yone-haru/coin-sorting-bank/hardware/sorter/sim/frame1.png

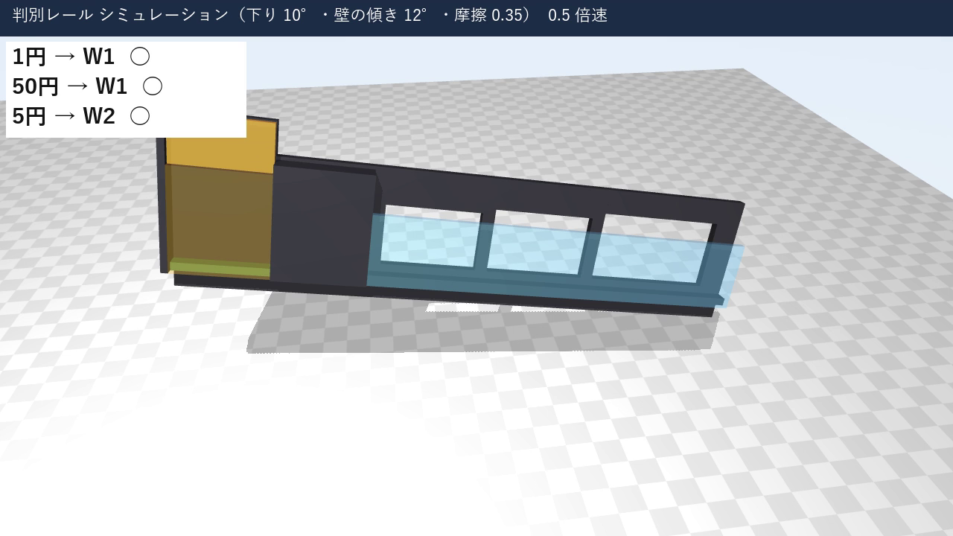
hardware/sorter/sim/frame1.png
