yone-haru/coin-sorting-bank/hardware/sorter/sim/test_frame.png

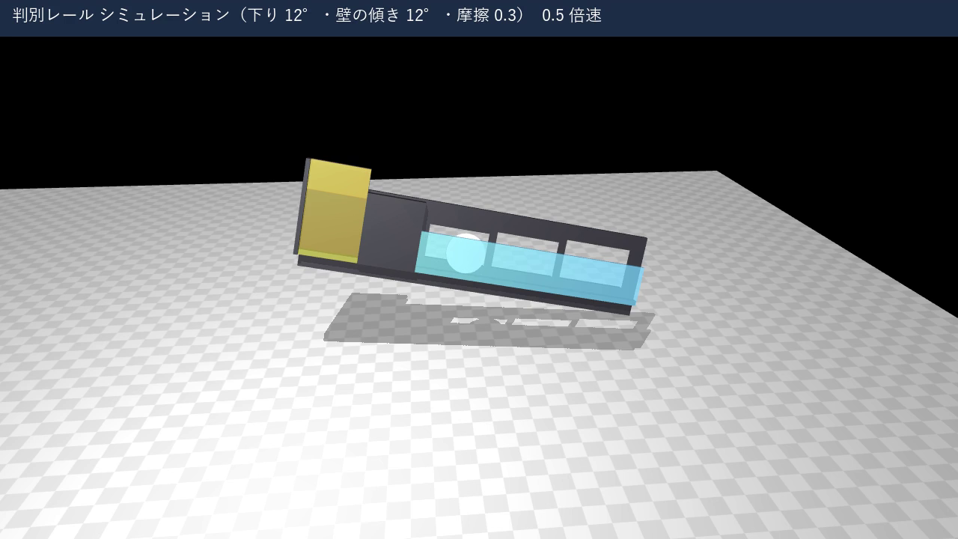
hardware/sorter/sim/test_frame.png
