yone-haru/coin-sorting-bank/hardware/sorter/ICB-86_実装手順.md

# ICB-86 無切断の中継基板実装

現物の ICB-86 を切らずに使う。穴の位置は **[ICB-86_配線図.html](ICB-86_配線図.html)** を参照（`python gen_ICB86配線html.py` で生成）。`基板設計/錫線だけ_配線図.html` と同じ形で、上が部品面から透かして見た図、下が裏返したはんだ面の図（左右反転）。橙色の線がつなぐ線で、図の端の文字がその線の元（センサーのどの足か・CN1 の何番か）。下の 2 つの表（先に付ける抵抗 5 本・これから付ける線 27 本。from・to・道・はんだの注意）にチェックを付けながら進める（チェックはブラウザに保存。付けた線は図でも灰色になる）。写真と同じく、銅箔面を見て「ICB-86」の文字を上にした向きで段数を数える。

**センサー本体は判別レールの指定穴に取り付ける。ICB-86にはセンサー本体を付けない。**レールから引いた線をICB-86へつなぐ。ICB-86に載せる部品は220Ω抵抗5本で、抵抗は銅箔面の反対側に置く。

| センサー | 赤外LED本体の位置 | 受光素子本体の位置 |
|---|---|---|
| P1・P2・P3 | 判別レールの床の下 | 硬貨の上側 |
| 穴A・穴B | 橋の塔 | レール裏の受光ホルダー |

## 銅箔の使い方

- 中央左の縦1列を **+5V**、中央右の縦1列を **GND** とする。2列は別の銅箔。
- 左の横3穴は各段で独立している。上から5～9段を、5個の **LED＋** に割り当てる。
- 右の横3穴も各段で独立している。上から12～16段を、5個の **受光C信号** に割り当てる。
- 抵抗は5本とも **220Ω**。各抵抗の片足を中央左+5V列、もう片足を同じ段の左3穴帯の左端へ挿す。左3穴帯の残る穴に、その段のLED＋線をつなぐ。5本を共用の抵抗1本にまとめない。

| 上からの段 | 左3穴帯：抵抗の先につなぐもの | 右3穴帯：2本を同じ段につなぐもの |
|---:|---|---|
| 5 | P3 LED＋ | — |
| 6 | P2 LED＋ | — |
| 7 | P1 LED＋ | — |
| 8 | 穴A LED＋ | — |
| 9 | 穴B LED＋ | — |
| 12 | — | P3 受光C、CN1-1 青 |
| 13 | — | P2 受光C、CN1-2 緑 |
| 14 | — | P1 受光C、CN1-3 黄 |
| 15 | — | 穴A 受光C、CN1-5 白 |
| 16 | — | 穴B 受光C、CN1-6 残りの1色 |

CN1-7の赤線は+5V縦列の1段へ。CN1-8の黒線はGND縦列の11段へ。各LEDの－はGND縦列の1～5段へ1本ずつ、各受光のEは同じGND縦列の6～10段へ1本ずつつなぐ。CN1-4は中継基板へ引かず、制御基板側でCN1-8へ接続済み。

**素子の足：**赤外LED `OSI5LA5113A` は長い足が＋（アノード）、短い足が－（カソード）。受光素子 `L-51ROPT1D1` は**短い足がC（コレクタ）、長い足がE（エミッタ）**。足を切る前に＋/－・C/Eを印しておく。根拠：[赤外LEDのデータシート](https://akizukidenshi.com/goodsaffix/OSI5LA5113A.pdf)、[受光素子の商品説明](https://akizukidenshi.com/catalog/g/g104211/)。

## 作業と確認

1. 12V電源とUSBを外す。220Ω抵抗5本を5～9段へ取り付ける。
2. CN1からの7本とセンサー5組の線を上の表どおりにつなぐ。継ぎ目は熱収縮チューブで絶縁し、線はレールの溝と吊り板のクリップに収める。
3. 電源を入れる前に、+5V縦列とGND縦列の短絡がないこと、左のLED＋5段相互および右の信号5段相互が短絡していないことを確認する。各抵抗の+5V列からLED＋穴まで約220Ωを確認する。
4. 制御基板につなぎ、各センサーを1組ずつ遮光・通光させて `sensortest` の変化を確かめる。

2026-10-06 に **ICB-86を切らずに使う案に決定**した（ユーザー指示）。`配線と固定.md`・`配線図_中継基板.png`・`基板設計/製作手順_制御基板.html` の「32×28mmに切ってレールの台に留める」記述はこの案に書き換えた。① 判別レールの中継基板の台とねじ2本は使わない（台は印刷済みのまま）。`組立図_本番/06_配線.png` とCADは中継基板を旧い台の位置で描いているので、線の長さは現物のICB-86に当てて決める。穴の割り当ては現物ではまだ確かめていない（上の「作業と確認」3で測る）。
