yone-haru/coin-sorting-bank/hardware/sorter/設計メモ.md

# 自作判別部 設計メモ（2026-09-26 着手）

> **2026-09-27：物理シミュレーションで寸法を決め直し、本番の形まで設計した（第 6・7 章）。**
> 本番の CAD は `判別ユニット_本番.scad`（STL は `本番STL/`、組立図は `組立図_本番/`）。
> 第 2〜4 章と `判別レール.scad`・`判別レール_試験一式.stl`・`組立図_自作.scad` は **9/26〜27 朝の旧案**（勾配 6°・傾き 20°・縁石なし）。
> 旧案のまま印刷すると、シミュレーションでは硬貨が途中で止まる。**印刷しないこと。**

とりだし君をやめ、判別部を含む制御ユニットの中身をすべて自前で設計する（ユーザー指示 9/26）。
オープンソースは仕組みの参考だけにして、形はすべてここで作る。**とりだし君案は自作版が各金種 50 枚の試験に合格するまで予備として残す。**

## 1. 判別方式の選定（調査の要約）

| 方式 | 5円/100円（0.6mm 差）の扱い | 判断 |
|---|---|---|
| 平置きで滑らせて穴に落とす（Improved Auto Coin Sorter など） | 穴の縁で 0.6mm を切る。勢いで飛び越える報告あり | × |
| 立てて転がし壁の窓から倒す（とりだし君と同じ原理） | 窓の高さで切る。射出成形なら ±0.3 で可、FDM では厳しい | ○（大まかに分ける用） |
| 高さの違う複数ビーム・2 ビームの時間差 | 光の境目がぼける・速度がばらつく | × |
| **穴センサー**（5円・50円の中心の穴を光が一瞬通る） | 穴 φ4〜5 に対しビーム φ1.5。余裕が桁違いに大きい | ◎（補助として） |
| 電子セレクタ・コイル・重さ・色 | 部品の追加や校正が要る | × |

**採用：「窓で 4 つに大まかに分ける ＋ 穴センサー 2 本」**

| レーン | 窓の高さ | 落ちる硬貨 | 同じレーンの 2 枚を分ける |
|---|---|---|---|
| W1 | 21.5 | 1円 20.0・50円 21.0 | 穴あり→50円 / なし→1円 |
| W2 | 23.05 | 5円 22.0・100円 22.6 | 穴あり→5円 / なし→100円 |
| W3 | 25.0 | 10円 23.5 | （穴なしを確認） |
| 終端 | — | 500円 26.5 | （穴なしを確認） |

- 0.6mm 差の 5円/100円 の境目を機械で切らない。機械のしきい値の余裕は最小 ±0.45mm（100円/10円）
- 穴センサーは 2 本（冗長）。1円/50円 と 5円/100円 のどちらも穴の有無だけで決まる
- 入力は 4 レーン＋穴 2 本＝**6 本。今の基板・配線・ピン（GPIO 4,5,3,10,20,21）をそのまま使える**

## 2. 形（判別レール）

- 壁の板（厚 3）に床リブ（幅 4）。硬貨は床の上に立ち、後ろへ 20° 傾いた壁にもたれて転がる（下り 6°）
- 窓は床の面から高さ H まで板を貫通。H より背の低い硬貨は支えを失い、壁の裏へ倒れて落ちる
- 窓の長さは「倒れ始め（硬貨の中心が上流の縁を越える）から抜けきるまで」の転がり量を見込んで 30 / 32 / 34mm（9/27 に着地場所 28mm を足すため 32/35/38 から詰めた）。
  下流側の縁は裏側へ 45° 面取りして、倒れかけた硬貨を裏へ導く
- 板を平置きで印刷（硬貨がもたれる面が上）。**窓の高さ＝しきい値が XY 方向になるので精度が出る**（補正 +0.1 は試験で合わせる）
- 穴センサーは上流の「橋」の下。LED は橋の塔に上から差し、受光素子は板の裏から。φ1.5 の絞り穴は同じ部品に開けるので位置が合う

## 3. 試験（`判別レール_試験一式.stl`）

一式：判別レール／受光素子ホルダー（裏に付ける）／試験台 2 個（上流・下流）。黒・壁 4 周・インフィル 30%・サポートなし。

1. 台 2 個の段に板の下端を載せ、裏を斜面にもたせる（勾配 6°・傾き 20°）
2. 上流端の床に硬貨を立て、壁にもたれさせて手を離す。各金種 10 回ずつ、どの窓で落ちるかを数える
   - 期待：1円・50円→W1、5円・100円→W2、10円→W3、500円→最後まで転がる
   - 見るところ：100円が W2 で落ちるか（余裕 0.45）、10円が W2 を越えるか（余裕 0.45）、硬貨が途中で止まらないか、窓を飛び越えないか
3. 穴センサー：橋の塔に LED、裏のホルダーに受光素子を差し、ブレッドボードの XIAO につなぐ（1 本で可）。
   `sensortest` で転がすと、穴あき硬貨（5円・50円）は **1 枚で HIGH が 2 回に割れる**。穴なしは 1 回
4. 結果で調整するもの：窓の高さの補正 `win_comp`、窓の長さ、勾配・傾き（台を作り直す）

## 4. 本番の構成（試験のあとで作る）

- 蓋の取付位置（投入スリット (175,56)・ボス）は変えない（クライアントの蓋は寸法図どおり）
- じょうご→関門 2.6mm→判別レールの上流端（着地場所 28mm）へ。**関門はスリットの左端の真下（X=155）**、
  レールは **右（+X）へ下り、硬貨の面は手前**、窓から倒れた硬貨は壁の奥側のシュートへ（2026-09-27 組立図で決定）。
  収まり：X 137〜329／Y 31〜82／蓋の裏から 163mm（箱の内側 X・Y 5〜345・内高 347）
- **注意：蓋の座標（X 右・Y 手前・Z 上）は鏡映し。**本物の形の STL を蓋の座標で置くときは Y で鏡映しにする（`組立図_自作.scad` の `pose()`）。
  本番のシュート・吊り具を蓋の座標で作ったら、印刷用 STL は `mirror([0,1,0])` して実物の向きに戻す
- 組立図：`python gen_組立図.py` → `組立図/01〜05_*.png`
- 窓の裏にシュート（硬貨を真下へ落とす溝）を付け、各シュートを横切るビームでレーンを検出（LED・受光素子の穴はシュートの部品に一体）
- 基板室は今の設計のまま流用

## 5. ファームウェアの変更（試験で穴の信号を確かめてから）

- ピンの意味だけ変える：GPIO4=500円（終端）／GPIO5=W2（5円・100円）／GPIO3=W1（1円・50円）／GPIO10=W3（10円）／GPIO20=穴 A／GPIO21=穴 B
- 穴ビームの 1 回の通過で「HIGH が 2 回に割れ、間の LOW が短い（全体の 1〜4 割）」→ 穴あり。
  硬貨 2 枚が接して通ると割れ目がほぼ 0 になるので、割れ目の比率で見分ける
- 穴の判定を FIFO に積み、レーンの検出が来たら古い順に取り出して金種を決める（硬貨はレール上で追い越さない）
- `CLAUDE.md` の「パルスを数える処理を書かない」「レーン＝金種」と食い違うので、採用が決まったら仕様を書き換える
- **9/27 変更：レーンのセンサーは「窓の裏」ではなく「溝を縦に貫く通過センサー P1〜P3」になった（第 7 章）。ピンの意味は第 7 章の表が正**

## 6. 物理シミュレーション（2026-09-27）

`sim/coin_sim.py`（MuJoCo 3.14）。寸法は `selfsort_params.scad` をそのまま読むので、CAD とずれない。

| コマンド | 内容 |
|---|---|
| `python coin_sim.py check` | 今の寸法で 6 金種を 1 回ずつ |
| `python coin_sim.py sweep '{"alpha":[8,10],...}'` | 形の組み合わせを総当たり → `analyze.py` で「ばらつきの中で一番悪い判別率」順に並べる |
| `python focus.py '{}' --seeds 16` | 1 つの形を、摩擦 0.2〜0.5・跳ね・窓の高さの印刷誤差 ±0.15 で何百回も |
| `python sensor_eval.py '{}'` | センサーの光を毎ステップ当てて、遮る・遮らないを確かめる |
| `python coin_sim.py video out.mp4` | 動画（`判別シミュレーション.mp4`） |

**分かったこと（旧案の欠陥）**

1. **勾配 6°・傾き 20° では硬貨が止まる。**壁との摩擦（μ × sin 傾き）が下りの力（sin 勾配）とほぼ同じ。→ 勾配 10°・傾き 12°
2. **窓が床の面から開いていると、大きい硬貨も落ちる。**窓の中では硬貨の下の縁を止めるものが無く、下の縁が窓へ滑り込む → 窓の下に**縁石 2.5mm**
3. **着地で跳ねた硬貨が W1 まで跳ね続け、窓から入り込む。**→ 着地場所の床に**フェルト 2mm**（無いと厳しい条件で 83%、あると 96〜99%）
4. **手前へ倒れて外へ出る。**→ 溝の手前に**前板**（すき間 4.5・床から 20mm）。すき間は「硬貨の厚み＋縁石＋余裕」必要（2.6 だと小さい硬貨が縁石を越えられず挟まる）
5. 10 円が W3 を飛び越える（終端で一番速い）→ W3 を 34→38
6. 窓の下流の縁は**角のまま**。表側を面取りすると落ちるべき硬貨まで壁へ押し戻される（27〜41% に悪化）。裏側の面取りは効果なし
7. 傾きは **12° が最良**（10° で 93%、14° で 98%）。組立の誤差は ±1° 以内に。勾配は 9〜11° でほぼ同じ

**最終の判別率**（計算が破綻した回＝物理的にあり得ない速さの回は除く）

| 条件 | 判別率 |
|---|---|
| 普通（摩擦 0.3〜0.4・跳ね普通・窓の高さ ±0.1） | **98.9%**（750/758） |
| 厳しい（摩擦 0.2 / 0.5・よく跳ねる・±0.15） | **98.6%**（343/348） |

残りの失敗は「途中で止まる」がほとんど。シミュレーションの摩擦は実物より「張り付き」やすい癖があり、実物では減る見込み（実機で確認）。
**シミュレーションは実物の代わりではない。**摩擦・跳ねを幅で振って「どの条件でも通る形」を選んだもの。最後は印刷して各金種 50 枚で確かめる。

## 7. 本番の構成（`判別ユニット_本番.scad`）

| 部品 | 大きさ | 印刷 |
|---|---|---|
| ① 判別レール | 179 × 105 × 20 | 硬貨がもたれる面を上。**PETG**（黒がよい）・壁 4・インフィル 30%・サポートなし。横向きの φ1.0 の絞り穴は印刷で埋まったら 1mm ドリルで通す。配線の溝（上下）と中継基板の台つき |
| ② 前板 | 121 × 25 × 2.5 | 内面を下 |
| ③ 受光ホルダー | 28 × 40 × 12 | そのまま |
| ④ 吊り板＋じょうご | 142 × 81 × 46 | 蓋に当たる面を下（腕とじょうごが上に立つ） |

- 取付：④ を蓋のボス 4 本に M4。① のマスト 2 本を ④ の腕に M3×8 タッピング 4 本（硬貨側から。9/27 に ×10 から直した：ねじは全部 ×8 にそろえる・×8 でも 5mm 以上かかる）。② は M3 3 本、③ は裏から M3 2 本
- **配線と固定：`配線と固定.md`**（センサーの線は上下の配線の溝へ、中継基板で手持ちの耐熱ワイヤー 7 本の束にまとめ、吊り板の下の印刷クリップで留めて基板室の CN1 へ。材料は PETG。買い足す物は無し）
- フェルト：**使わない**（2026-09-27 決定。床は平ら）。よく跳ねる条件でだけ効く（あり 98.6%・なし 87.8%）ので、試験で跳ねが目立てば予備の `①判別レール_フェルトあり（予備）.stl` とフェルト 2mm に切り替える
- ねじ：M3×8 タッピング 25 本・M4×10 タッピング 8 本＋M4 ワッシャー 8 枚（貯金箱全体。内訳は `配線と固定.md` 第 5 章）
- 色：灰色の PETG。センサーのブロックは壁を厚くし、印刷後に外側を黒の油性ペンで塗る
- 置き場所：関門の口を (X 165, 奥から 56, 蓋の裏から 35)。レールは X 142〜319。④ は蓋のリブの無い範囲（X 132〜274・奥から 16〜96）に収まる
- **座標は右手系（Y＝奥向き）で作った。**蓋の図面の座標（Y＝手前向き）を 3D にそのまま使うと鏡像になるため（基板室の件と同じ）

**センサー（6 本・GPIO は今のまま）**

| GPIO | センサー | 位置 | 意味 |
|---|---|---|---|
| 20 | 穴 A | x 35（橋） | 硬貨が入った合図・穴の有無 |
| 21 | 穴 B | x 49（橋） | 同上（冗長） |
| 3 | 通過 P1 | x 98（W1 の後） | ここを通った＝1円/50円ではない |
| 5 | 通過 P2 | x 134（W2 の後） | ここを通った＝5円/100円ではない |
| 4 | 通過 P3 | x 173.5（W3 の後） | ここを通った＝500円 |
| 10 | 予備 | — | （使わない） |

**判定のしかた（ファーム v3.0 で実装済み・9/27。`firmware/lib/CoinTracker` ＋ `firmware/src/main_selfsort.cpp`。詳しくは第 9 章と `CLAUDE.md` 第 3A 章）**：穴 A/B で「入った」と「穴の有無」→ 入口から P1 まで最大 0.6 秒、P2 まで 0.77、P3 まで 0.82（シミュレーションの最大値）。
期限までに P1 を通らなければ W1（穴あり→50円・なし→1円）、P1 を通って P2 を通らなければ W2（穴あり→5円・なし→100円）、P2 を通って P3 を通らなければ 10円、P3 を通れば 500円。
硬貨はレール上で追い越さないので FIFO で追う。~~CLAUDE.md の「レーン＝金種」「パルスを数えない」とは食い違う~~ → 9/27 に CLAUDE.md へ第 3A 章（自作版）を足し、第 2〜3 章はとりだし君版と明記した

## 8. 全体テスト（2026-09-27 深夜）

`sim/system_test.py single|burst`。硬貨の物理 → センサー 5 本の信号 → 判定ロジック → 鳴る音 を通しで確かめる。
判定ロジックは同ファイルの `decide()`（v2）が**ファームに移す仕様の下書き**。結果と工程の抜けは `../../全体テストと工程チェック_2026-09-27.md`。

## 9. ファームウェア v3.0（2026-09-27）

`decide()`（第 8 章）を C++ に移した。**`firmware/lib/CoinTracker`**（判定・Arduino なし・PC で単体テスト）＋ **`firmware/src/main_selfsort.cpp`**（ISR・DFPlayer・ログ・コマンド）。
既定のビルドは `pio run -e esp32c3`（自作版）。とりだし君版 v2.1 は `pio run -e esp32c3_lane` で今でも作れる。仕様・定数・ログの形は `CLAUDE.md` 第 3A 章。

### 9.1 `decide()` との突き合わせ（シミュレーション 472 件＝1 枚ずつ 426・連続 46・硬貨 978 枚）

全体テストの 472 件のセンサー信号を `CoinTracker` に 1ms 刻みで流し、`decide()` の結果と比べた。

| 設定 | `decide()` と同じ結果 | 全部正しいケース | 正しい硬貨 ※ |
|---|---|---|---|
| 拾う機能なし（`SS_ADOPT_ORPHAN=false`） | **472/472**（決まる時刻の差も 0） | 451 | 817/978 |
| 拾う機能あり＋ **40ms の条件**（本番の設定） | 468/472 | **453** | **852/978** |

※ 枚数が合ったケースだけ入れた順に比べる（1 枚でも取りこぼしたケースは 0 と数える）ので、連続投入のケースで低く出る。

- 違った 4 件（462・463・467・471。どれも連続投入）は、**`decide()` が取りこぼした硬貨を拾って音を鳴らした**もの。
  うち 3 件は拾った金額も正しい。462 は枚数が合ったが、隣の 1 枚が 100円→5円 になった
- **40ms の条件（`SS_ADOPT_MIN_MS`）を入れた理由**：条件なしで拾うと、56・85・435 で**余計な音が 1 回ずつ**鳴った。
  P を通った硬貨が次の窓へ傾くとき、同じ P を 15〜31ms 遮り直すのが原因。本物の通過は 54ms 以上なので、40ms 以上の遮光だけを拾う。これで 3 件とも消えた

### 9.2 PC 上の結合テスト（`main_selfsort.cpp` をそのまま動かす）

Arduino・DFPlayer・WDT を PC 上の代わり（時計は 64bit の偽物）に置き換え、ISR からエッジを入れて音の番号とログを確かめた。**80/80 合格**（通常 66・起動時にビームが遮られている 8・DFPlayer なし 6）。

- 6 金種 × 速さ 5 通り（120/180/250/400/700 mm/s）で正しい音
- loop が 100ms 止まっても 6/6 正しい（ISR の時刻で判定しているため）／loop が 20ms ごとでも正しい
- `sim`（既定・120・900 mm/s・変な引数）、詰まり（`JAM?`・LED のゆっくり点滅）、`stats`/`reset`、`sensortest`（穴あき 50円で HA・HB が 2 回に割れる）
- DFPlayer が無いとき ERROR（LED 高速点滅・以後止まる）
- `micros()` の一周（約 71 分）をまたいでも正しい

### 9.3 分かった限界

- **2 枚の間隔**（250mm/s・HA に来る時刻の差。36 通りの組み合わせを 300→40ms で調べた）：
  多くの組み合わせは **170〜180ms** まで正しい。500円・10円・5円が前にいる組み合わせのいくつかは 90〜110ms まで大丈夫。
  **一番悪いのは 10円→50円・10円→1円 の 270ms**。これより詰まると 2 枚を 1 枚（穴あり）と数える。
  原因は `SS_GROUP_GAP_MS`（80ms）より短い光の戻りを同じ硬貨とみなすため（`decide()` も同じ）。ゲートで 1 枚ずつにするのが前提
- **長い遮光のあと**：HB が約 2.6 秒遮られてから光が戻ると、`NOTE noA longB` を出して 1 枚として音を鳴らした（金額は 1円・速さ不明）。
  詰まった硬貨が抜けたとき、手をかざしたときに起きる。無音よりよいと考えてそのままにしている（実機試験で困るなら見直す）

### 9.4 実機で確かめること

1. `sensortest` で 5 本のビームが硬貨で HIGH になるか（プルアップ 22kΩ で足りるか）。穴あき 50円・5円で HA・HB が 2 回に割れるか
2. 硬貨の実際の速さ（`COIN` 行の `v=`）→ 期限の係数 `SS_K_DEADLINE`・`SS_T_MARGIN_MS` を詰める（音が鳴るまでの時間を短くできる）
3. 各金種 50 枚で 98% 以上（判別率は `CSV` 行から集計）
