yone-haru/coin-sorting-bank/hardware/sorter/ICB-86_実装図.png

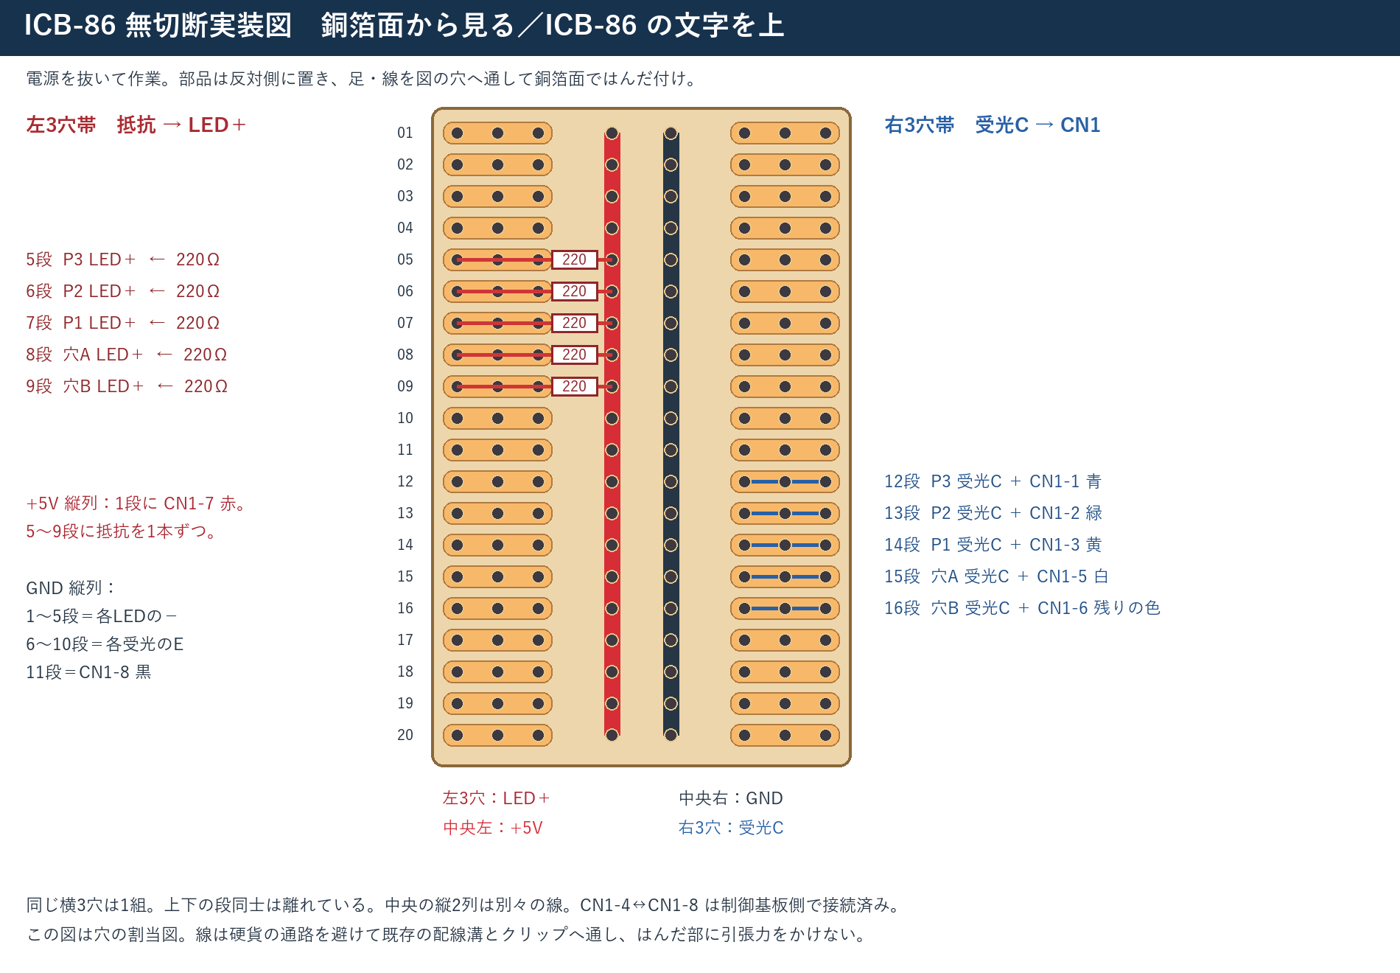
hardware/sorter/ICB-86_実装図.png
