yone-haru/coin-sorting-bank/hardware/sorter/sim/frame2.png

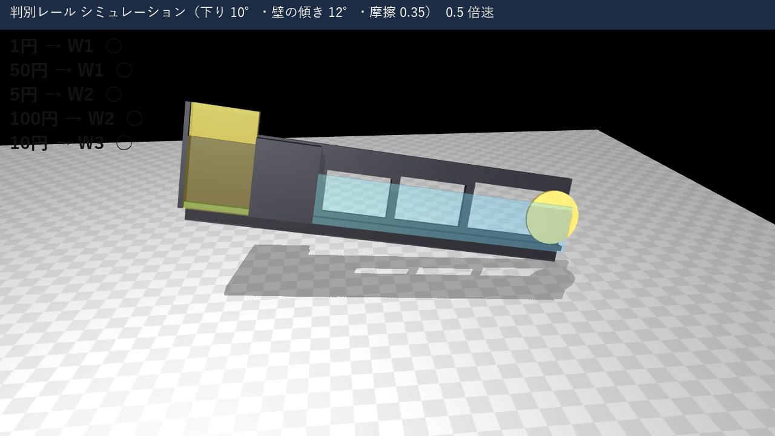
hardware/sorter/sim/frame2.png
