yone-haru/coin-sorting-bank/hardware/sorter/配線図_中継基板.png

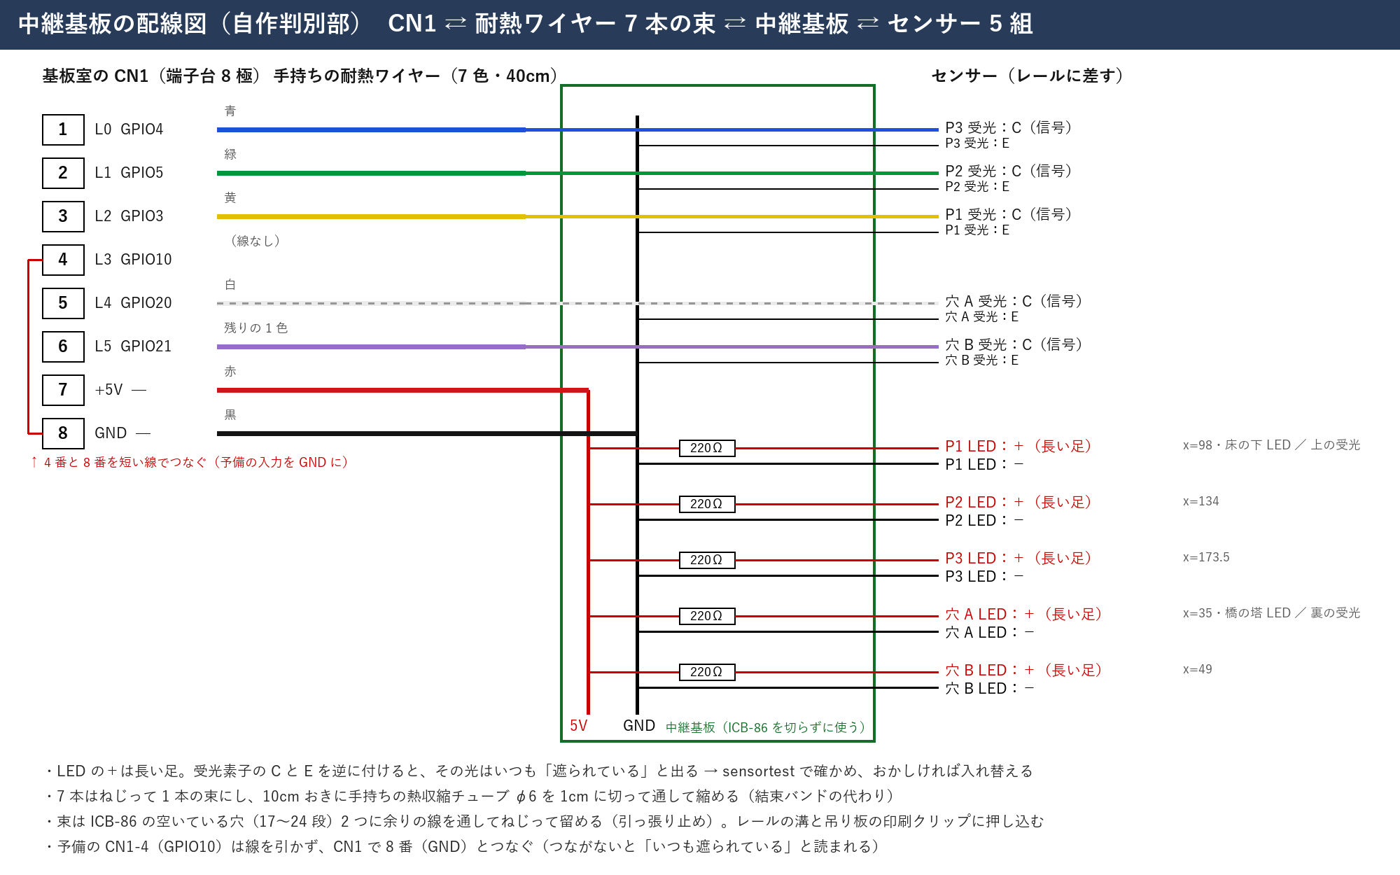
hardware/sorter/配線図_中継基板.png
