yone-haru/coin-sorting-bank/hardware/sorter/stl/⑤-1押さえ_通過LED×3.stl

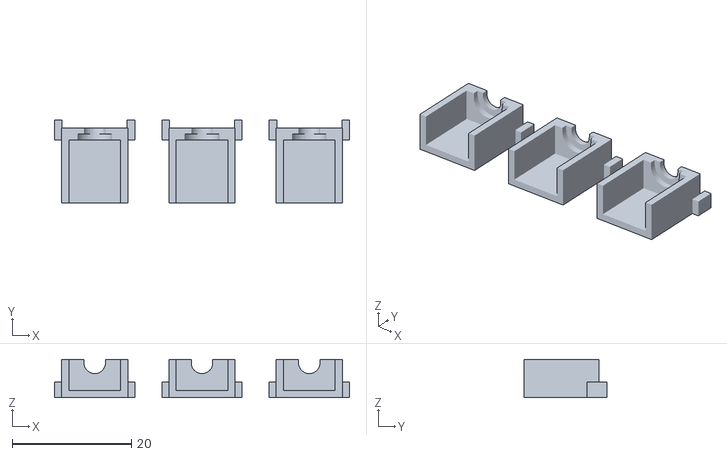
[picture p6: CAD file, 2026-10-10]
hardware/sorter/stl/⑤-1押さえ_通過LED×3.stl
49.5 x 13.9 x 6.45
