yone-haru/coin-sorting-bank/hardware/sorter/stl/⑤-2押さえ_通過受光×3.stl

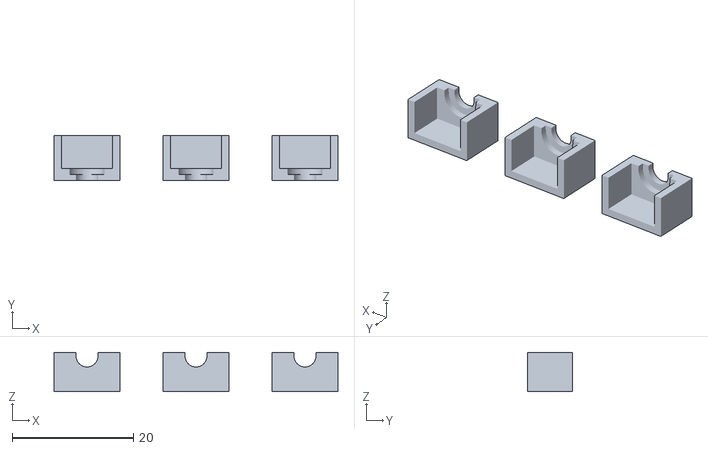
[picture p7: CAD file, 2026-10-10]
hardware/sorter/stl/⑤-2押さえ_通過受光×3.stl
46.9 x 7.40 x 6.45
