yone-haru/coin-sorting-bank/hardware/sorter/stl/⑧脚×4.stl

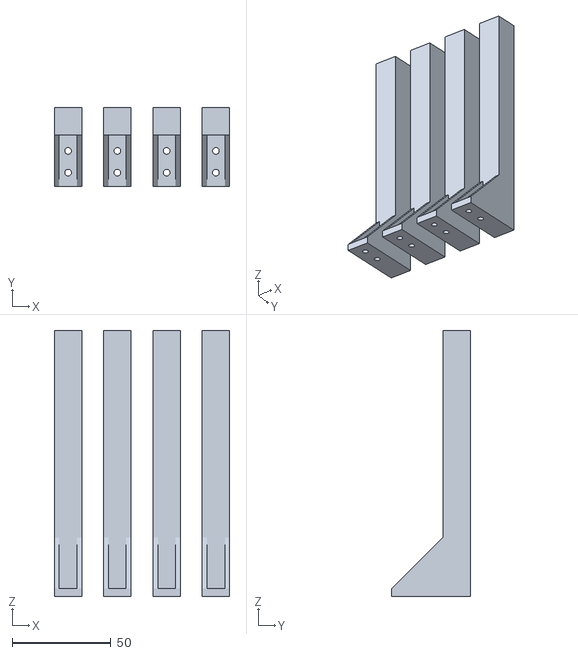
[picture p8: CAD file, 2026-10-10]
hardware/sorter/stl/⑧脚×4.stl
89.0 x 40.0 x 135.0
