yone-haru/coin-sorting-bank/hardware/sorter/stl/③受光ホルダー.stl

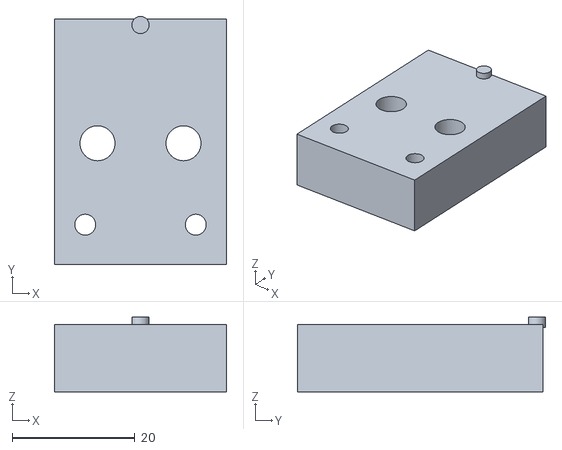
[picture p9: CAD file, 2026-10-10]
hardware/sorter/stl/③受光ホルダー.stl
28.0 x 40.4 x 12.2
