yone-haru/coin-sorting-bank/hardware/sorter/stl/⑤押さえキャップ_まとめ（⑤-1×2・⑤-2×2・⑤-3×1）.stl

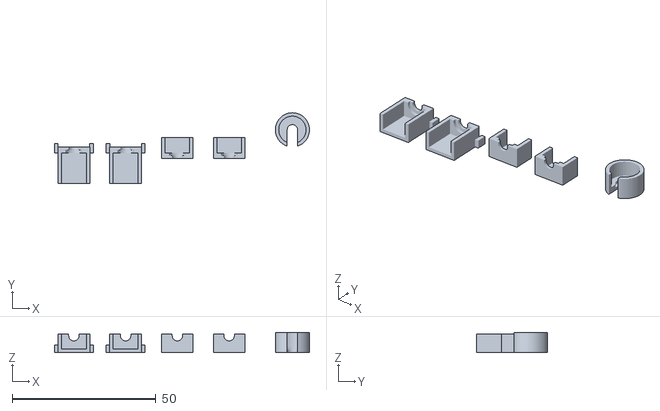
[picture p10: CAD file, 2026-10-10]
hardware/sorter/stl/⑤押さえキャップ_まとめ（⑤-1×2・⑤-2×2・⑤-3×1）.stl
88.7 x 24.5 x 7.00
