yone-haru/coin-sorting-bank/hardware/sorter/stl/④吊り板.stl

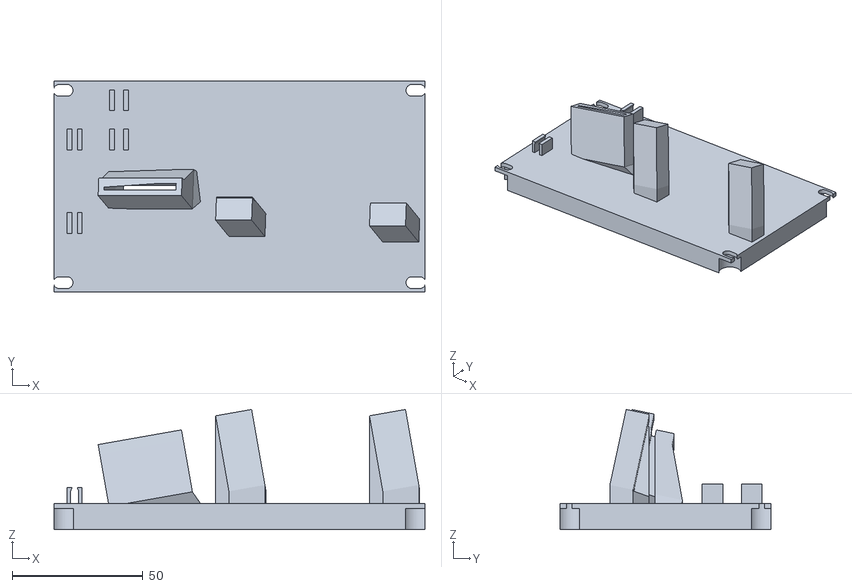
[picture p11: CAD file, 2026-10-10]
hardware/sorter/stl/④吊り板.stl
142.0 x 80.6 x 46.0
