yone-haru/coin-sorting-bank/hardware/sorter/stl/⑤-3押さえ_穴LED×2.stl

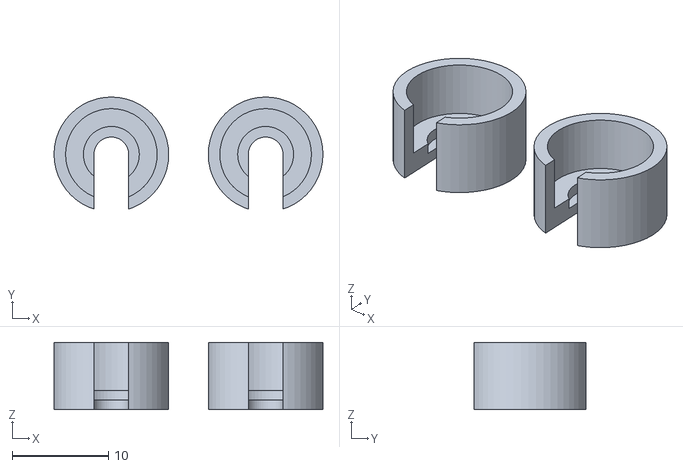
[picture p12: CAD file, 2026-10-10]
hardware/sorter/stl/⑤-3押さえ_穴LED×2.stl
27.9 x 11.6 x 7.00
