yone-haru/coin-sorting-bank/hardware/sorter/stl/①判別レール.stl

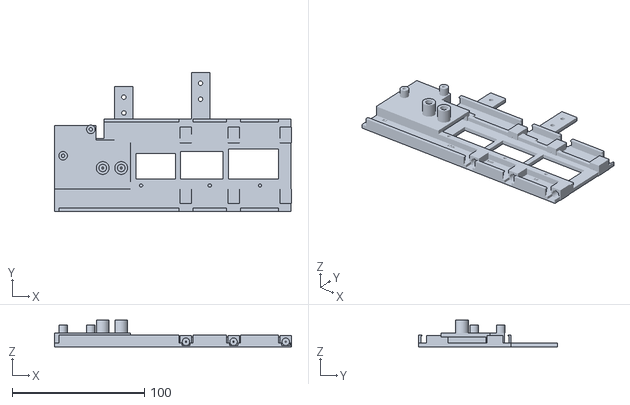
[picture p13: CAD file, 2026-10-10]
hardware/sorter/stl/①判別レール.stl
179.3 x 104.8 x 20.1
