yone-haru/coin-sorting-bank/hardware/sorter/stl/⑤押さえキャップ_試し刷り（⑤-2・⑤-3 1個ずつ）.stl

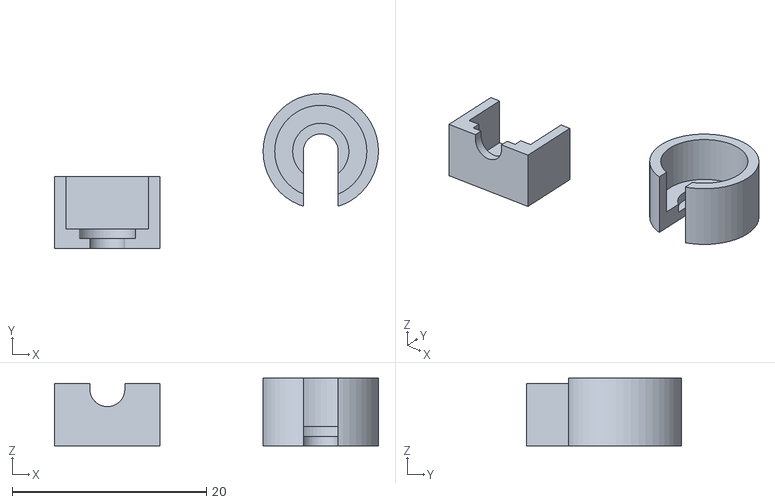
[picture p14: CAD file, 2026-10-10]
hardware/sorter/stl/⑤押さえキャップ_試し刷り（⑤-2・⑤-3 1個ずつ）.stl
33.4 x 15.9 x 7.00
