yone-haru/coin-sorting-bank/hardware/sorter/stl/⑥天板B.stl

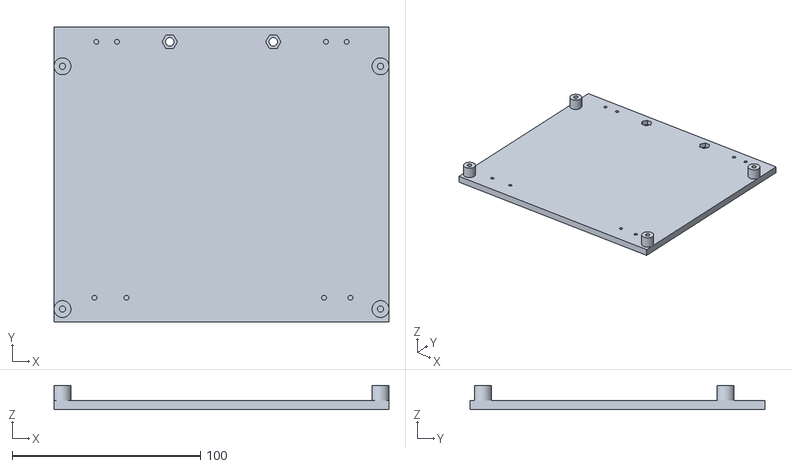
[picture p15: CAD file, 2026-10-10]
hardware/sorter/stl/⑥天板B.stl
178.0 x 157.0 x 13.0
