yone-haru/coin-sorting-bank/hardware/sorter/stl/⑦継ぎ板（左右）.stl

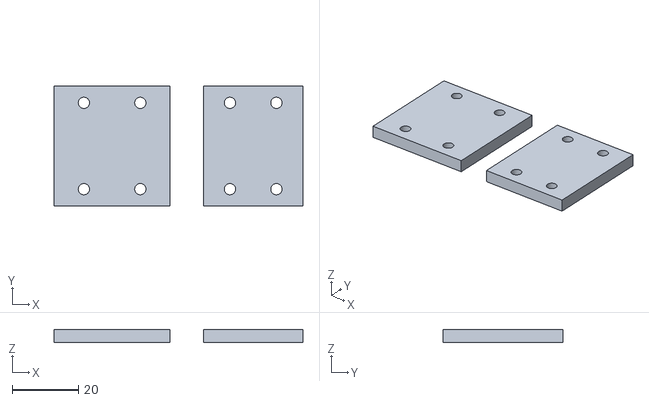
[picture p16: CAD file, 2026-10-10]
hardware/sorter/stl/⑦継ぎ板（左右）.stl
75.0 x 36.0 x 4.00
