yone-haru/coin-sorting-bank/hardware/sorter/stl/⑥天板A.stl

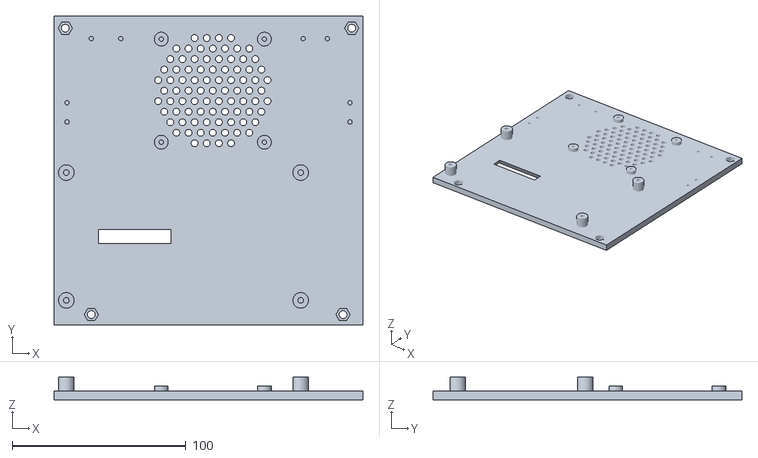
[picture p17: CAD file, 2026-10-10]
hardware/sorter/stl/⑥天板A.stl
178.0 x 178.0 x 13.0
