yone-haru/coin-sorting-bank/hardware/sorter/stl/⑤-4押さえ_穴受光×1.stl

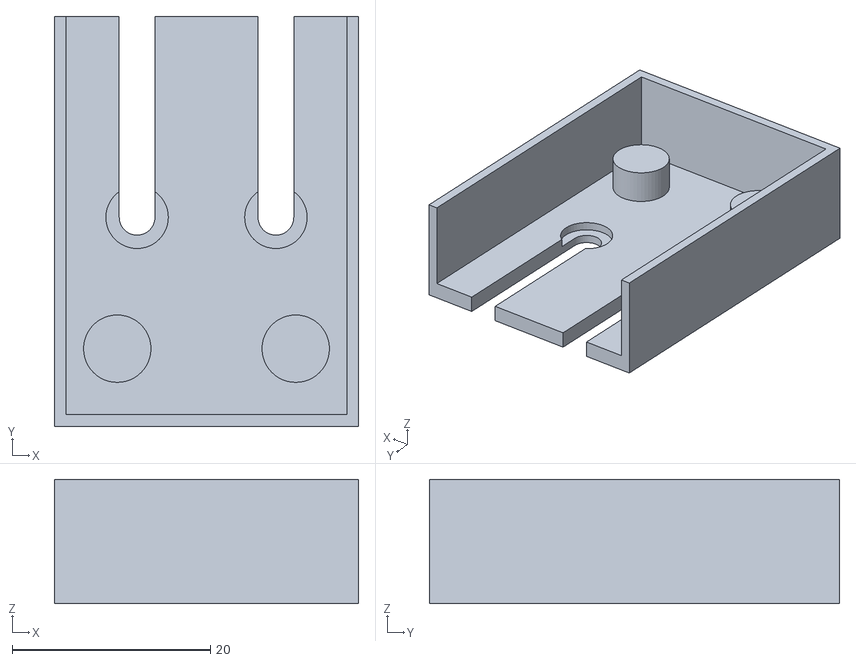
[picture p18: CAD file, 2026-10-10]
hardware/sorter/stl/⑤-4押さえ_穴受光×1.stl
30.7 x 41.4 x 12.5
