yone-haru/coin-sorting-bank/hardware/sorter/stl/②前板.stl

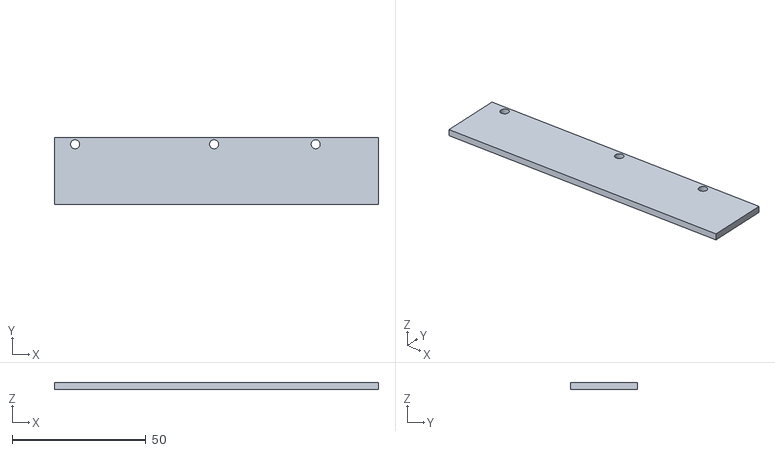
[picture p19: CAD file, 2026-10-10]
hardware/sorter/stl/②前板.stl
121.2 x 25.0 x 2.50
