yone-haru/coin-sorting-bank/(list of files, cad)

Other CAD files:
hardware/sorter/stl/①判別レール_フェルトあり（予備）.stl
