yone-haru/coin-sorting-bank/hardware/sorter/assembly/01_全体_手前の左下から.png

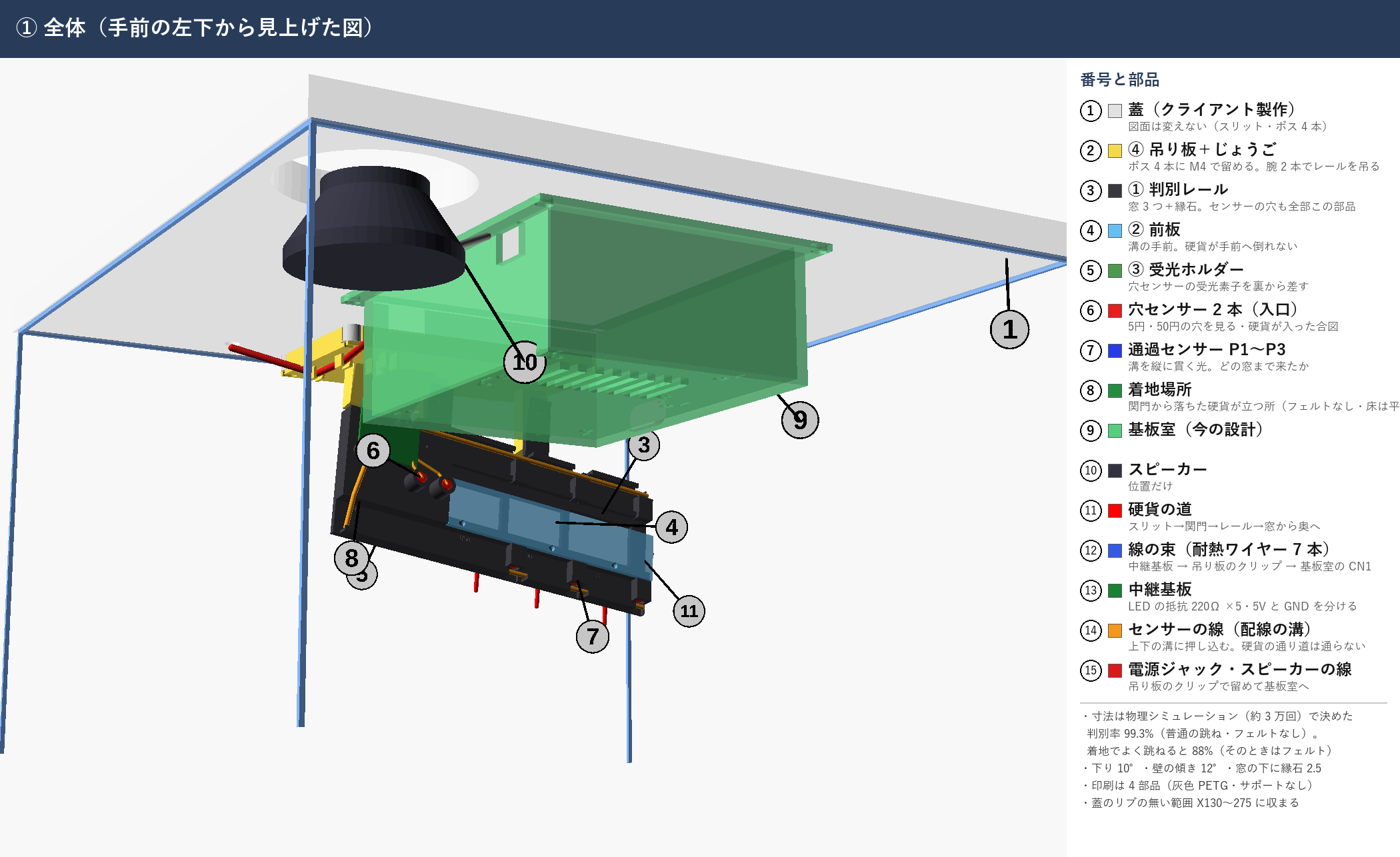
hardware/sorter/assembly/01_全体_手前の左下から.png
