yone-haru/coin-sorting-bank/hardware/sorter/assembly/02_手前から_硬貨の面.png

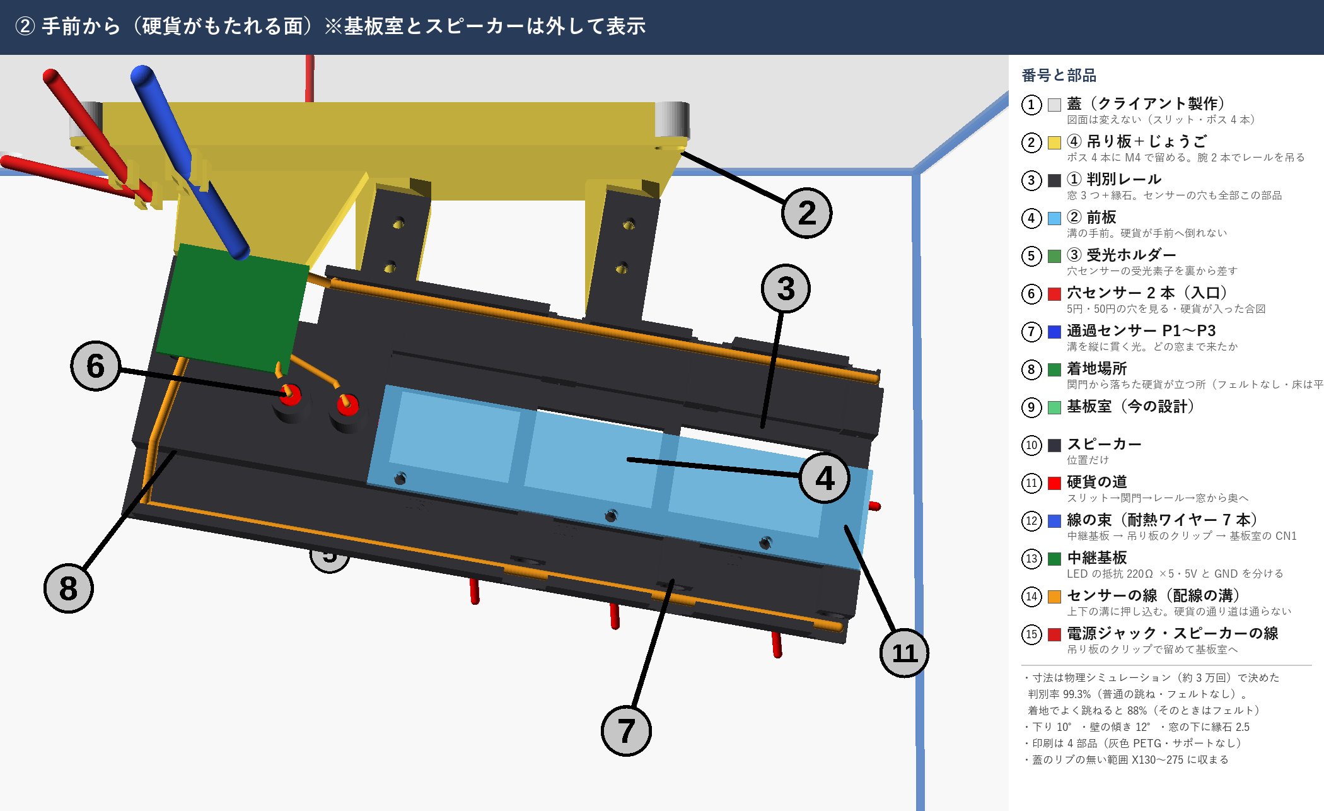
hardware/sorter/assembly/02_手前から_硬貨の面.png
