yone-haru/coin-sorting-bank/hardware/sorter/assembly/03_奥から.png

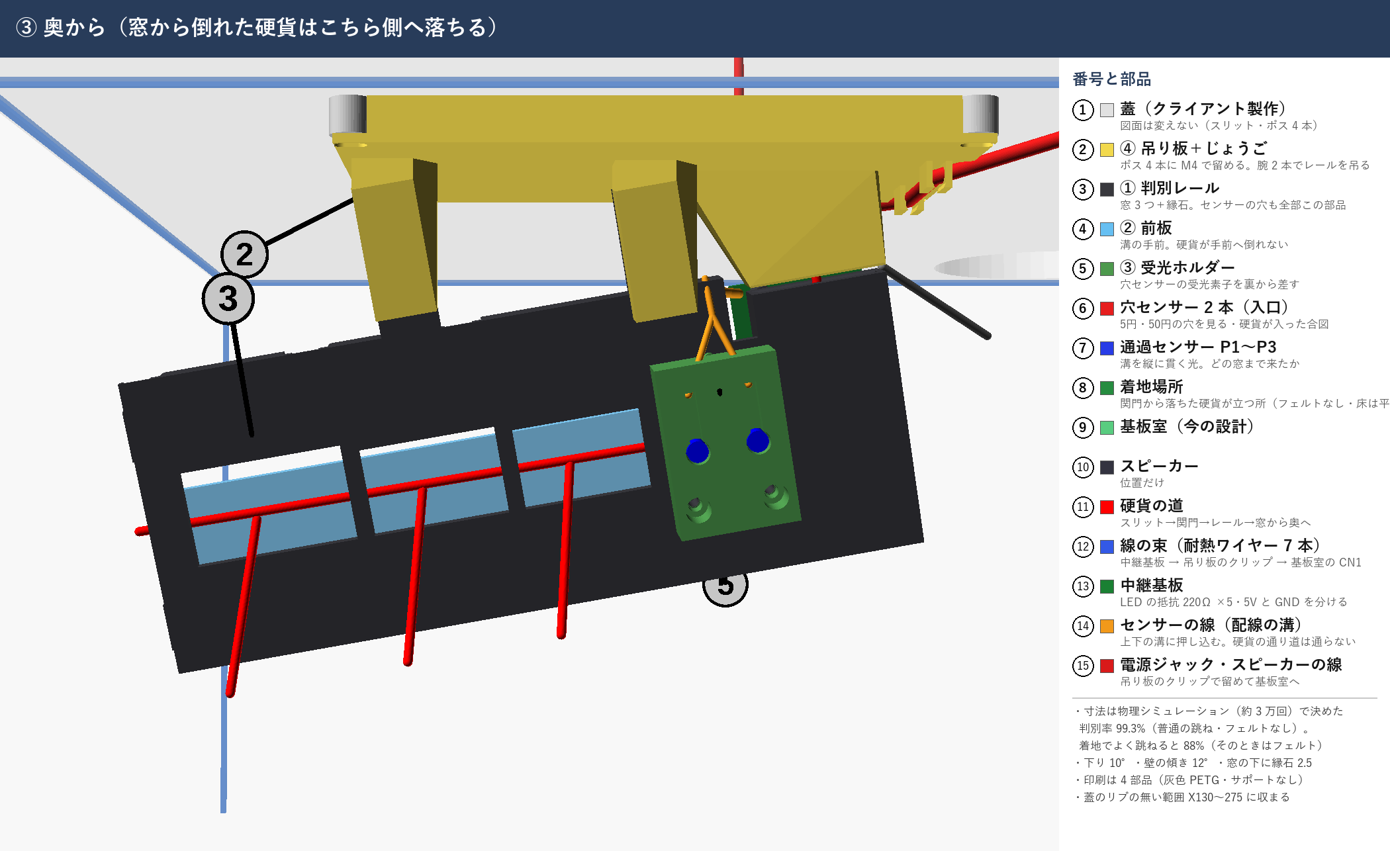
hardware/sorter/assembly/03_奥から.png
