yone-haru/coin-sorting-bank/hardware/sorter/assembly/04_上から_配置.png

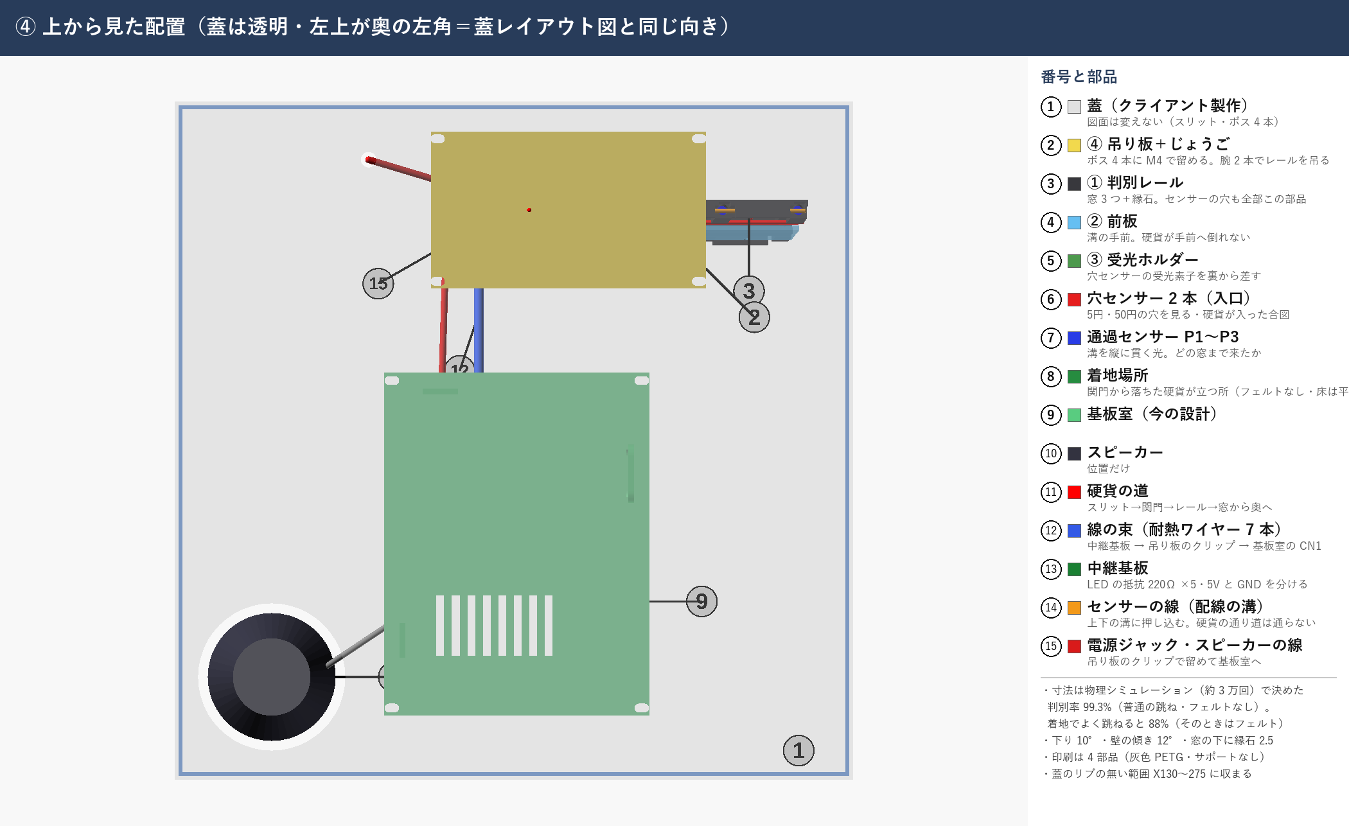
hardware/sorter/assembly/04_上から_配置.png
