yone-haru/coin-sorting-bank/hardware/sorter/assembly/05_分解図.png

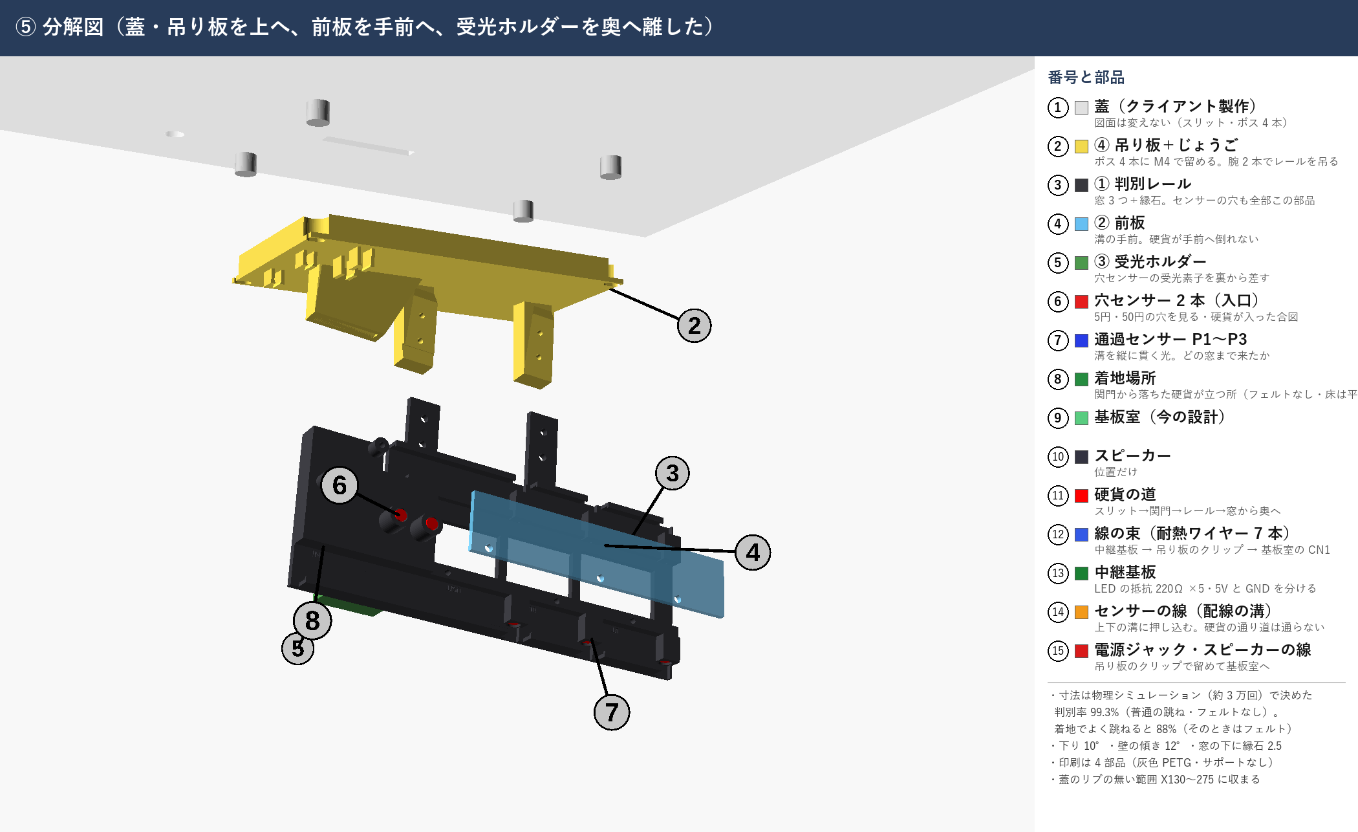
hardware/sorter/assembly/05_分解図.png
