yone-haru/coin-sorting-bank/hardware/sorter/assembly/06_配線.png

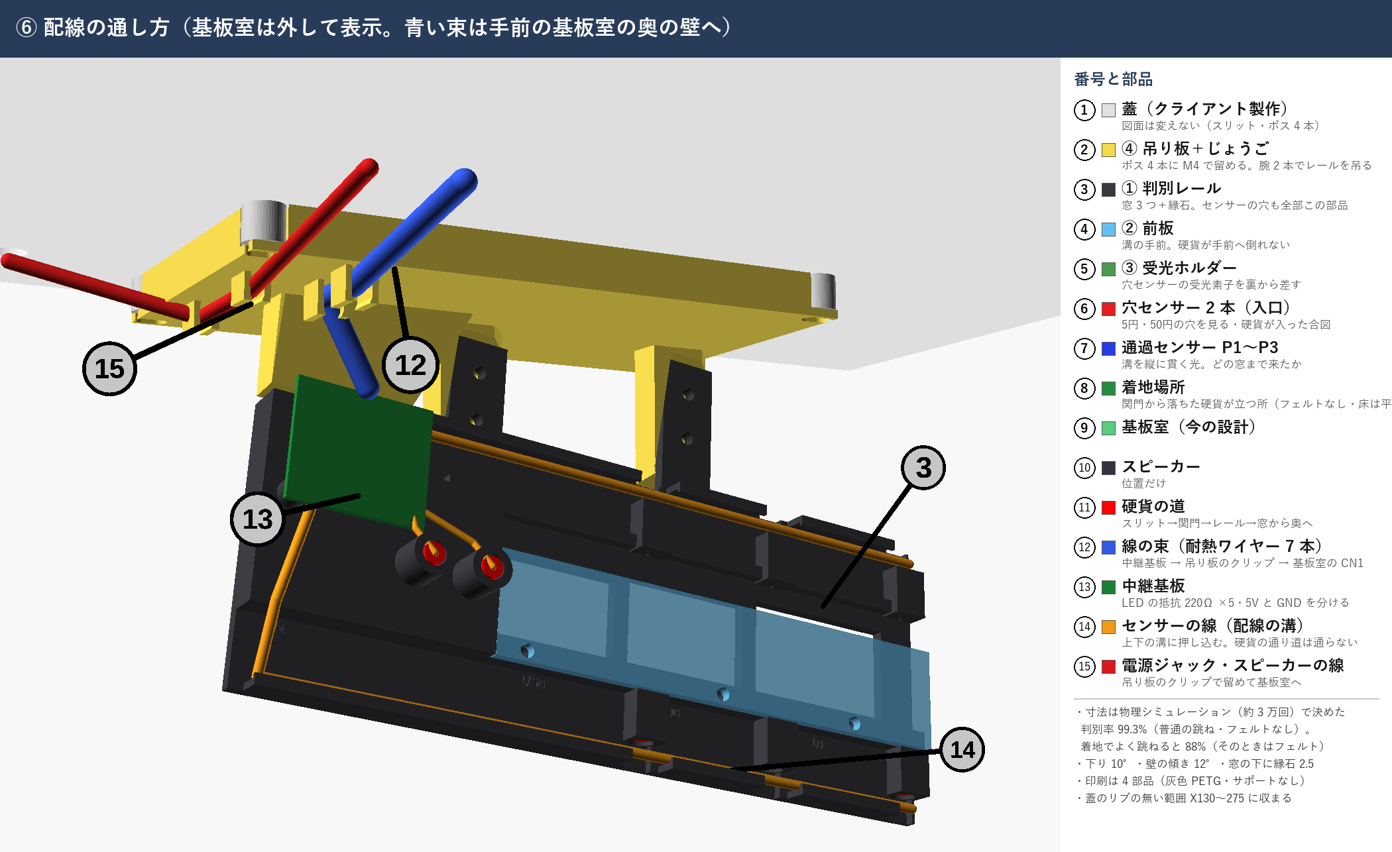
hardware/sorter/assembly/06_配線.png
