yone-haru/coin-sorting-bank/hardware/sorter/sim/funnel_result.txt

=== OLD ===  (入口の層 y=77.5 → 出口 y=16.0)
  pitch 1円     最悪のずれ (0, 0, 0)  入口で入れる角度 0 通れる角度 0  通れる割合 0%  通れる角 None
  pitch 10円    最悪のずれ (0, 0, 0)  入口で入れる角度 0 通れる角度 0  通れる割合 0%  通れる角 None
  pitch 500円   最悪のずれ (0, 0, 0)  入口で入れる角度 0 通れる角度 0  通れる割合 0%  通れる角 None
  pitch 1円x2(重ね)  最悪のずれ (0, 0, 0)  入口で入れる角度 0 通れる角度 0  通れる割合 0%  通れる角 None
  pitch 500+1円(重ね)  最悪のずれ (0, 0, 0)  入口で入れる角度 0 通れる角度 0  通れる割合 0%  通れる角 None
  yaw   1円     最悪のずれ (0, 0, 0)  入口で入れる角度 0 通れる角度 0  通れる割合 0%  通れる角 None
  yaw   10円    最悪のずれ (0, 0, 0)  入口で入れる角度 0 通れる角度 0  通れる割合 0%  通れる角 None
  yaw   500円   最悪のずれ (0, 0, 0)  入口で入れる角度 0 通れる角度 0  通れる割合 0%  通れる角 None
  yaw   1円x2(重ね)  最悪のずれ (0, 0, 0)  入口で入れる角度 0 通れる角度 0  通れる割合 0%  通れる角 None
  yaw   500+1円(重ね)  最悪のずれ (0, 0, 0)  入口で入れる角度 0 通れる角度 0  通れる割合 0%  通れる角 None
=== NEW ===  (入口の層 y=77.5 → 出口 y=16.0)
  pitch 1円     最悪のずれ (0, 0, 0)  入口で入れる角度 0 通れる角度 0  通れる割合 0%  通れる角 None
  pitch 10円    最悪のずれ (0, 0, 0)  入口で入れる角度 0 通れる角度 0  通れる割合 0%  通れる角 None
  pitch 500円   最悪のずれ (0, 0, 0)  入口で入れる角度 0 通れる角度 0  通れる割合 0%  通れる角 None
  pitch 1円x2(重ね)  最悪のずれ (0, 0, 0)  入口で入れる角度 0 通れる角度 0  通れる割合 0%  通れる角 None
  pitch 500+1円(重ね)  最悪のずれ (0, 0, 0)  入口で入れる角度 0 通れる角度 0  通れる割合 0%  通れる角 None
  yaw   1円     最悪のずれ (0, 0, 0)  入口で入れる角度 0 通れる角度 0  通れる割合 0%  通れる角 None
  yaw   10円    最悪のずれ (0, 0, 0)  入口で入れる角度 0 通れる角度 0  通れる割合 0%  通れる角 None
  yaw   500円   最悪のずれ (0, 0, 0)  入口で入れる角度 0 通れる角度 0  通れる割合 0%  通れる角 None
  yaw   1円x2(重ね)  最悪のずれ (0, 0, 0)  入口で入れる角度 0 通れる角度 0  通れる割合 0%  通れる角 None
  yaw   500+1円(重ね)  最悪のずれ (0, 0, 0)  入口で入れる角度 0 通れる角度 0  通れる割合 0%  通れる角 None
