yone-haru/coin-sorting-bank/hardware/sorter/sim/_d_result.txt

== D1 By63 Bz3.1-11.6
  +0.0 1円 通れる100.0% OK 詰まるy=None
  +0.2 1円 通れる  0.0% NG 詰まるy=59.0
  +0.0 10円 通れる  0.0% NG 詰まるy=60.0
  +0.2 10円 通れる  0.0% NG 詰まるy=61.0
  +0.0 500円 通れる  0.0% NG 詰まるy=64.0
  +0.2 500円 通れる  0.0% NG 詰まるy=65.0
== D2 By60 Bz3.1-10
  +0.0 1円 通れる  0.0% NG 詰まるy=59.0
  +0.2 1円 通れる  0.0% NG 詰まるy=60.0
  +0.0 10円 通れる  0.0% NG 詰まるy=60.0
  +0.2 10円 通れる  0.0% NG 詰まるy=63.0
  +0.0 500円 通れる  0.0% NG 詰まるy=64.0
  +0.2 500円 通れる  0.0% NG 詰まるy=64.0
== D3 By66 Bz3.1-13
  +0.0 1円 通れる100.0% OK 詰まるy=None
  +0.2 1円 通れる100.0% OK 詰まるy=None
  +0.0 10円 通れる100.0% OK 詰まるy=None
  +0.2 10円 通れる  0.0% NG 詰まるy=60.0
  +0.0 500円 通れる  0.0% NG 詰まるy=64.0
  +0.2 500円 通れる  0.0% NG 詰まるy=65.0
