yone-haru/coin-sorting-bank/hardware/sorter/sim/funnel_2d_result.txt

=== OLD ===
  厚み+0.0 1円    通れる入口姿勢   0.0%  到達 NG(詰まる)  詰まる高さ y=55.0
  厚み+0.0 50円   通れる入口姿勢   0.0%  到達 NG(詰まる)  詰まる高さ y=55.0
  厚み+0.0 100円  通れる入口姿勢   0.0%  到達 NG(詰まる)  詰まる高さ y=56.0
  厚み+0.0 10円   通れる入口姿勢   0.0%  到達 NG(詰まる)  詰まる高さ y=56.0
  厚み+0.0 500円  通れる入口姿勢   0.0%  到達 NG(詰まる)  詰まる高さ y=58.0
  厚み+0.2 1円    通れる入口姿勢   0.0%  到達 NG(詰まる)  詰まる高さ y=55.0
  厚み+0.2 50円   通れる入口姿勢   0.0%  到達 NG(詰まる)  詰まる高さ y=55.0
  厚み+0.2 100円  通れる入口姿勢   0.0%  到達 NG(詰まる)  詰まる高さ y=56.0
  厚み+0.2 10円   通れる入口姿勢   0.0%  到達 NG(詰まる)  詰まる高さ y=56.0
  厚み+0.2 500円  通れる入口姿勢   0.0%  到達 NG(詰まる)  詰まる高さ y=58.0
=== NEW ===
  厚み+0.0 1円    通れる入口姿勢   0.0%  到達 NG(詰まる)  詰まる高さ y=61.0
  厚み+0.0 50円   通れる入口姿勢   0.0%  到達 NG(詰まる)  詰まる高さ y=62.0
  厚み+0.0 100円  通れる入口姿勢   0.0%  到達 NG(詰まる)  詰まる高さ y=63.0
  厚み+0.0 10円   通れる入口姿勢   0.0%  到達 NG(詰まる)  詰まる高さ y=62.0
  厚み+0.0 500円  通れる入口姿勢   0.0%  到達 NG(詰まる)  詰まる高さ y=65.0
  厚み+0.2 1円    通れる入口姿勢   0.0%  到達 NG(詰まる)  詰まる高さ y=62.0
  厚み+0.2 50円   通れる入口姿勢   0.0%  到達 NG(詰まる)  詰まる高さ y=63.0
  厚み+0.2 100円  通れる入口姿勢   0.0%  到達 NG(詰まる)  詰まる高さ y=64.0
  厚み+0.2 10円   通れる入口姿勢   0.0%  到達 NG(詰まる)  詰まる高さ y=64.0
  厚み+0.2 500円  通れる入口姿勢   0.0%  到達 NG(詰まる)  詰まる高さ y=66.0
