yone-haru/coin-sorting-bank/hardware/sorter/sim/_h_fix1.txt

== ['3.0', '5.6', '3', '0', '3', '6', '10円', '500円', '1円']
10円 (0.4, 0.4, 0.2) (True, np.float64(16.0))
10円 (0, 0.4, 0) (True, np.float64(16.0))
10円 (0.4, 0.4, -0.2) (True, np.float64(16.0))
10円 (-0.4, -0.4, -0.2) (True, np.float64(16.0))
500円 (0.4, 0.4, 0.2) (True, np.float64(16.0))
