yone-haru/coin-sorting-bank/hardware/board/netlist.py

# -*- coding: utf-8 -*-
"""
コイン別音声貯金箱 制御基板 — ネットリスト（唯一の正）
=============================================================================
このファイルが回路の定義そのものです。
回路図（KiCad）も実体配線図もここから生成し、両者が一致することを verify.py で照合します。
**回路を変えるときは、このファイルだけを直してください。**

出典：CLAUDE.md §2（ピンアサイン・レーン1本の回路）／回路図 v2.0
=============================================================================

用語
  PART : 基板に載る部品。pins はピン番号 → ピン名
  NET  : つながる場所の集合。("R11", "1") のように (部品, ピン番号) で書く
  基板外 : DCジャック・センサー・アンプキット・スピーカーは基板の外。
           端子台（TB1 / TB2 / TB3 / CN1）を通して出入りする
"""

# =============================================================================
# 部品表
#   footprint: 実体配線図で使う穴の使い方
#     "axial-N"   : 抵抗・ダイオードを N 穴ぶん寝かせる（2.54mm ピッチ）
#     "radial-N"  : 電解コンデンサ等。N 穴あけて2本足
#     "dip-RxC"   : 2列のソケット・モジュール
#     "sip-N"     : 1列 N ピン
#     "block-N"   : 端子台（5.0mm ピッチ ＝ 2 穴ぶん）を N 極ぶん
# =============================================================================

PARTS = {
    # ---- 電源入力まわり -------------------------------------------------
    "TB1": dict(value="端子台 2P", desc="12V入力（DCジャックから）", footprint="block-2",
                pins={"1": "+12V_IN", "2": "GND"}, akizuki="115682"),
    "F1":  dict(value="MF-R185", desc="ポリスイッチ 1.85A", footprint="radial-3",
                pins={"1": "A", "2": "B"}, akizuki="112629"),
    "D1":  dict(value="SR54F", desc="逆接保護ショットキー（SMD チップ。両端に線を付けて足にする）", footprint="axial-5",
                pins={"1": "A", "2": "K"}, akizuki="106125", polarity="1=アノード 2=カソード(帯)"),
    "C1":  dict(value="470uF/25V", desc="12V 平滑", footprint="radial-3",
                pins={"1": "+", "2": "-"}, akizuki="117883", polarity="1=+（長い足）"),

    # ---- 5V 生成 ---------------------------------------------------------
    "U1":  dict(value="BP5293-50", desc="三端子DC-DC 12V→5V 1A", footprint="sip-3",
                pins={"1": "IN", "2": "GND", "3": "OUT"}, akizuki="111188",
                note="78xx と同じ IN・GND・OUT の並び。向きを印字で確認"),
    "C2":  dict(value="220uF/16V", desc="5V 平滑", footprint="radial-2",
                pins={"1": "+", "2": "-"}, akizuki="110272", polarity="1=+（長い足）"),

    # ---- XIAO への 5V（USB逆流防止）-------------------------------------
    "D2":  dict(value="SR54F", desc="XIAO 5Vピンへの逆流防止（SMD チップ。両端に線を付けて足にする）", footprint="axial-5",
                pins={"1": "A", "2": "K"}, akizuki="106125", polarity="1=アノード 2=カソード(帯)"),

    # ---- DFPlayer のノイズ対策 ------------------------------------------
    "R1":  dict(value="1R", desc="DFPlayer VCC 直列（必須）", footprint="axial-5",
                pins={"1": "1", "2": "2"}, akizuki="125010"),
    "C3":  dict(value="100uF/16V", desc="DFPlayer VCC（必須）", footprint="radial-2",
                pins={"1": "+", "2": "-"}, akizuki="110271", polarity="1=+（長い足）"),

    # ---- マイコン・音源 --------------------------------------------------
    "U2":  dict(value="XIAO ESP32C3", desc="マイコン（ソケットに挿す）", footprint="dip-2x7",
                akizuki="117454",
                pins={"1": "D0/GPIO2",  "2": "D1/GPIO3",  "3": "D2/GPIO4",
                      "4": "D3/GPIO5",  "5": "D4/GPIO6",  "6": "D5/GPIO7",
                      "7": "D6/GPIO21", "8": "D7/GPIO20", "9": "D8/GPIO8",
                      "10": "D9/GPIO9", "11": "D10/GPIO10", "12": "3V3",
                      "13": "GND",      "14": "5V"},
                note="1〜7が片側（USB側から D0→D6）、14〜8が反対側（USB側から 5V→D7）"),
    "U3":  dict(value="DFPlayer Mini", desc="MP3モジュール（ソケットに挿す）", footprint="dip-2x8",
                akizuki="112544",
                pins={"1": "VCC", "2": "RX", "3": "TX", "4": "DAC_R",
                      "5": "DAC_L", "6": "SPK_2", "7": "GND", "8": "SPK_1",
                      "9": "IO_1", "10": "GND2", "11": "IO_2", "12": "ADKEY_1",
                      "13": "ADKEY_2", "14": "USB+", "15": "USB-", "16": "BUSY"},
                note="1〜8が片側、16〜9が反対側（1の向かいが16）"),

    # ---- 音声出力（アンプキットへ）--------------------------------------
    "C6":  dict(value="1uF", desc="音声カップリング", footprint="axial-3",
                pins={"1": "1", "2": "2"}, akizuki="115874"),
    "VR1": dict(value="10k 半固定", desc="音量（基板室の壁の穴から回す）", footprint="tri-3",
                pins={"1": "1", "2": "W", "3": "3"}, akizuki="103277",
                note="1=入力側 2=ワイパー(中央) 3=GND側"),

    # ---- ステータス LED --------------------------------------------------
    "R4":  dict(value="470R", desc="LED1 電流制限", footprint="axial-5",
                pins={"1": "1", "2": "2"}, akizuki="125471"),
    "R5":  dict(value="10k", desc="GPIO8 プルアップ（必須）", footprint="axial-5",
                pins={"1": "1", "2": "2"}, akizuki="125103"),
    "LED1": dict(value="3mm 赤", desc="ステータスLED（LOWで点灯）", footprint="radial-1",
                pins={"1": "A", "2": "K"}, akizuki="111577", polarity="1=アノード(長い足) 2=カソード"),

    # ---- 外部との接続 ----------------------------------------------------
    "CN1": dict(value="端子台 2P×4", desc="センサー6本＋5V＋GND", footprint="block-8",
                akizuki="115682",
                pins={"1": "L0", "2": "L1", "3": "L2", "4": "L3",
                      "5": "L4", "6": "L5", "7": "+5V", "8": "GND"}),
    "TB2": dict(value="端子台 2P", desc="アンプキットへ 12V 供給", footprint="block-2",
                pins={"1": "+12V", "2": "GND"}, akizuki="115682"),
    "TB3": dict(value="端子台 2P", desc="アンプキットへ 音声入力", footprint="block-2",
                pins={"1": "AUDIO", "2": "GND"}, akizuki="115682"),
}

# ---- レーン入力回路 ×6（22kΩ プルアップ ＋ 1kΩ 直列）----------------------
# CLAUDE.md「レーン1本の回路」より：
#   3V3 ──[22k]──┬── (CN1 経由でフォトトランジスタへ)
#                 └──[1k]── GPIO
LANES = [
    # (レーン番号, 金種, XIAOのピン番号, XIAOのピン名)
    (0, 500, "3",  "D2/GPIO4"),
    (1, 100, "4",  "D3/GPIO5"),
    (2,  50, "2",  "D1/GPIO3"),
    (3,  10, "11", "D10/GPIO10"),
    (4,   5, "8",  "D7/GPIO20"),
    (5,   1, "7",  "D6/GPIO21"),
]

for i, yen, _pin, _name in LANES:
    PARTS[f"R1{i+1}"] = dict(value="22k", desc=f"レーン{i}({yen}円) プルアップ", footprint="axial-5",
                             pins={"1": "1", "2": "2"}, akizuki="125223")
    PARTS[f"R2{i+1}"] = dict(value="1k", desc=f"レーン{i}({yen}円) GPIO直列保護", footprint="axial-5",
                             pins={"1": "1", "2": "2"}, akizuki="125102")


# =============================================================================
# ネットリスト
#   net名: [(部品, ピン番号), ...]
# =============================================================================

NETS = {
    # ---- 12V 系 ---------------------------------------------------------
    "VIN":     [("TB1", "1"), ("F1", "1")],
    "VFUSED":  [("F1", "2"), ("D1", "1")],
    "+12V":    [("D1", "2"), ("C1", "1"), ("U1", "1"), ("TB2", "1")],

    # ---- 5V 系 ----------------------------------------------------------
    "+5V":     [("U1", "3"), ("C2", "1"), ("D2", "1"), ("R1", "1"), ("CN1", "7")],
    "XIAO_5V": [("D2", "2"), ("U2", "14")],
    "DF_VCC":  [("R1", "2"), ("C3", "1"), ("U3", "1")],

    # ---- 3.3V 系（XIAO の内蔵レギュレータ出力）--------------------------
    "+3V3":    [("U2", "12"), ("R4", "1"), ("R5", "1")]
               + [(f"R1{i+1}", "1") for i, _, _, _ in LANES],

    # ---- GND ------------------------------------------------------------
    "GND":     [("TB1", "2"), ("C1", "2"), ("U1", "2"), ("C2", "2"), ("C3", "2"),
                ("U2", "13"), ("U3", "7"), ("U3", "10"),
                ("VR1", "3"), ("CN1", "8"), ("TB2", "2"), ("TB3", "2")],

    # ---- UART（XIAO ⇄ DFPlayer）----------------------------------------
    "UART_TX": [("U2", "5"), ("U3", "2")],   # XIAO D4/GPIO6 → DFPlayer RX
    "UART_RX": [("U2", "6"), ("U3", "3")],   # XIAO D5/GPIO7 ← DFPlayer TX

    # ---- 音声 ------------------------------------------------------------
    "DAC_L":   [("U3", "5"), ("C6", "1")],
    "VOL_IN":  [("C6", "2"), ("VR1", "1")],
    "AUDIO":   [("VR1", "2"), ("TB3", "1")],

    # ---- ステータス LED（アクティブ LOW）--------------------------------
    "LED_A":   [("R4", "2"), ("LED1", "1")],
    "LED_K":   [("LED1", "2"), ("R5", "2"), ("U2", "9")],   # = GPIO8
}

# ---- レーン ×6 --------------------------------------------------------------
for i, yen, xiao_pin, _name in LANES:
    # センサーから来た線を 22k でプルアップし、1k を通して GPIO へ
    NETS[f"LANE{i}_SENS"] = [("CN1", str(i + 1)), (f"R1{i+1}", "2"), (f"R2{i+1}", "1")]
    NETS[f"LANE{i}_GPIO"] = [(f"R2{i+1}", "2"), ("U2", xiao_pin)]


# =============================================================================
# 未接続（意図的に何も繋がないピン）— ERC で「未接続」と怒られないように印を付ける
# =============================================================================
NO_CONNECT = [
    ("U2", "1"),   # D0/GPIO2  ストラップピン。使用禁止
    ("U2", "10"),  # D9/GPIO9  ストラップピン(BOOT)。使用禁止
    ("U3", "4"),   # DAC_R     モノラルなので未使用
    ("U3", "6"),   # SPK_2     内蔵アンプは使わない
    ("U3", "8"),   # SPK_1     同上
    ("U3", "9"),   # IO_1      未使用
    ("U3", "11"),  # IO_2      未使用
    ("U3", "12"),  # ADKEY_1   未使用
    ("U3", "13"),  # ADKEY_2   未使用
    ("U3", "14"),  # USB+      未使用
    ("U3", "15"),  # USB-      未使用
    ("U3", "16"),  # BUSY      未使用（空きGPIOが無いため）
]


# =============================================================================
# 自己検査：全ピンが「ネットに入っている」か「未接続宣言済み」かのどちらかであること
# =============================================================================
def check():
    problems = []

    used = {}
    for net, nodes in NETS.items():
        for ref, pin in nodes:
            if ref not in PARTS:
                problems.append(f"ネット {net}: 部品 {ref} が部品表にありません")
                continue
            if pin not in PARTS[ref]["pins"]:
                problems.append(f"ネット {net}: {ref} にピン {pin} がありません")
                continue
            key = (ref, pin)
            if key in used:
                problems.append(f"{ref}.{pin} が {used[key]} と {net} の両方に入っています（短絡）")
            used[key] = net

    nc = set(NO_CONNECT)
    for ref, part in PARTS.items():
        for pin in part["pins"]:
            if (ref, pin) not in used and (ref, pin) not in nc:
                problems.append(f"{ref}.{pin}（{part['pins'][pin]}）がどのネットにも入っていません")

    for ref, pin in NO_CONNECT:
        if (ref, pin) in used:
            problems.append(f"{ref}.{pin} は未接続宣言なのに {used[(ref,pin)]} に繋がっています")

    for net, nodes in NETS.items():
        if len(nodes) < 2:
            problems.append(f"ネット {net} に接続先が1つしかありません")

    return problems


if __name__ == "__main__":
    probs = check()
    print(f"部品 {len(PARTS)} 個 ／ ネット {len(NETS)} 本 ／ "
          f"接続点 {sum(len(v) for v in NETS.values())} 箇所 ／ 未接続宣言 {len(NO_CONNECT)} 箇所")
    if probs:
        print(f"\n【問題 {len(probs)} 件】")
        for p in probs:
            print("  -", p)
    else:
        print("\n自己検査：問題なし")
